Jaycar-Electronics/Music-Beat-Bar/images/support.jpg

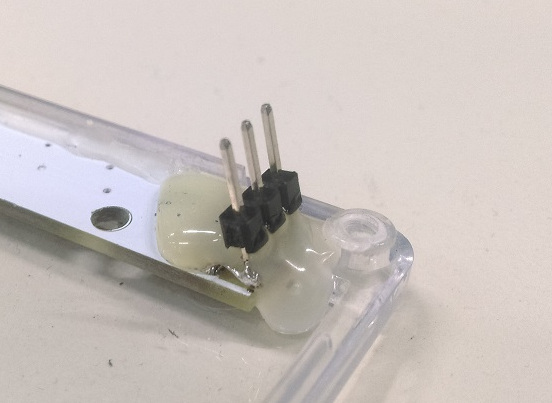
images/support.jpg
